enginvr/MESP/MESP_board_real.png

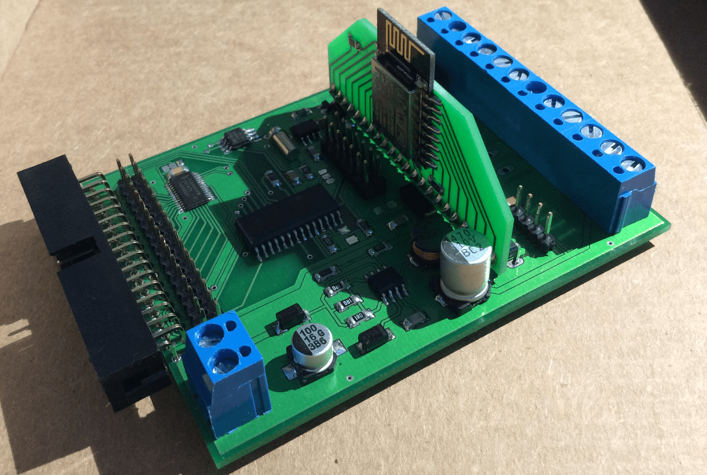
MESP_board_real.png
