enginvr/MESP/README.md

MESP, это аппаратная реализация проекта ESP8266 MegaD api http://ab-log.ru/forum/viewtopic.php?f=1&t=1130.

Основная информация в документе Guide.pdf
