enginvr/MESP/esp MD 3D.png

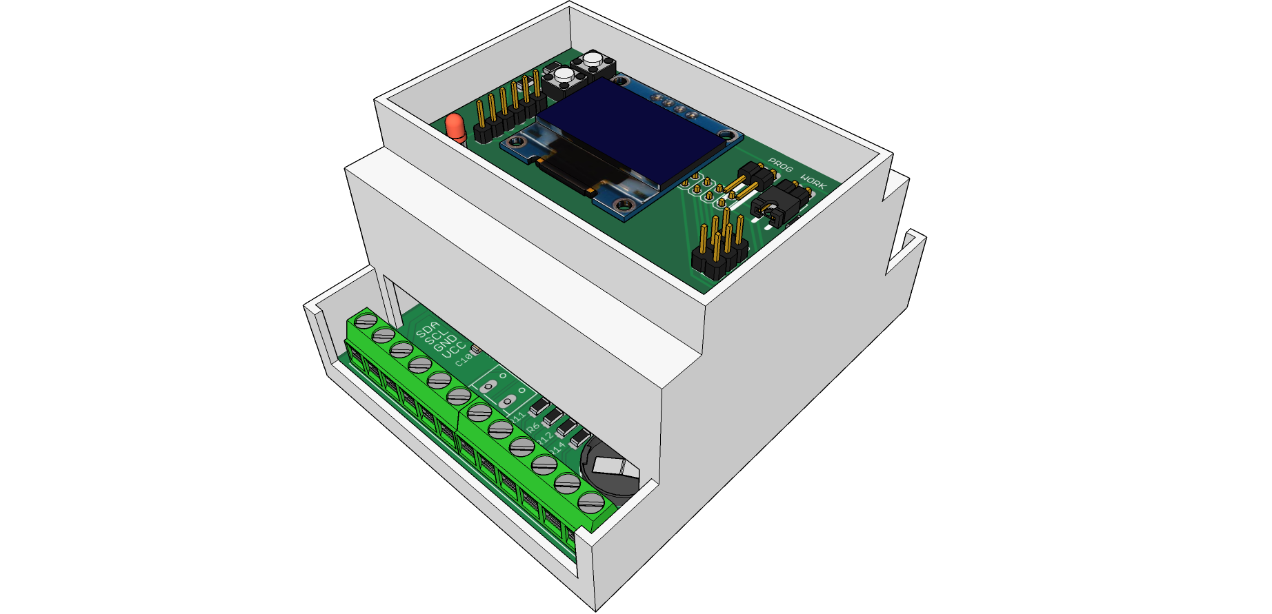
esp MD 3D.png
