enginvr/MESP/scheme_adapter_board.png

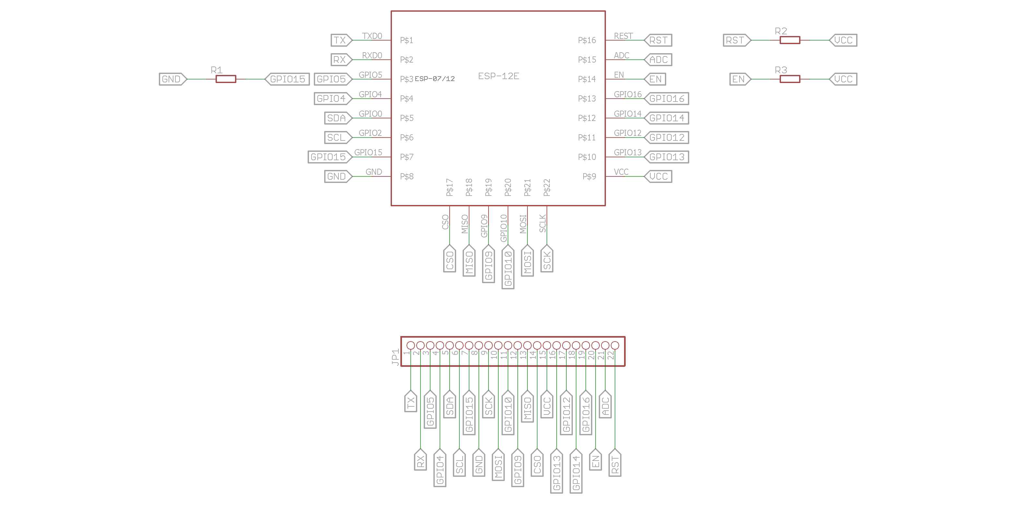
scheme_adapter_board.png
