enginvr/MESP/scheme_main_board.png

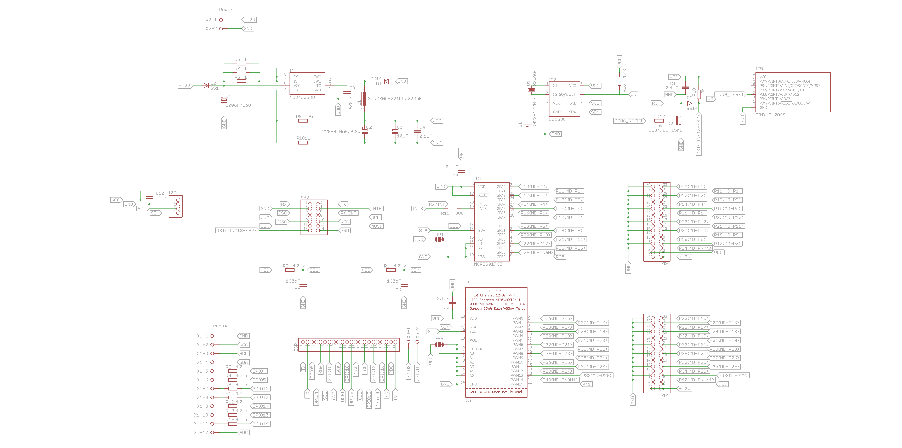
scheme_main_board.png
