enginvr/MESP/scheme_top_board.png

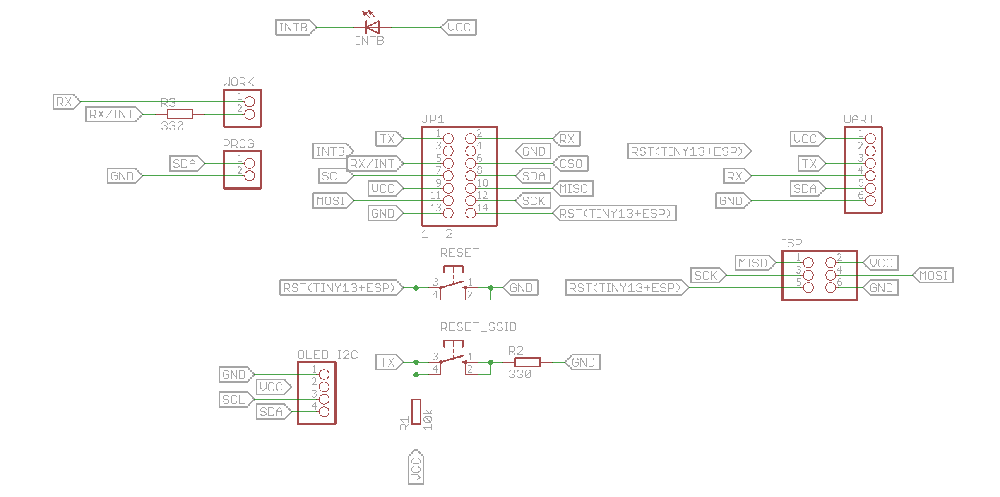
scheme_top_board.png
