enginvr/MESP/EagleCAD schemes/ESP8266 MegaD top board.sch

## EAGLE design EagleCAD schemes/ESP8266 MegaD top board.sch (2016-11-07)

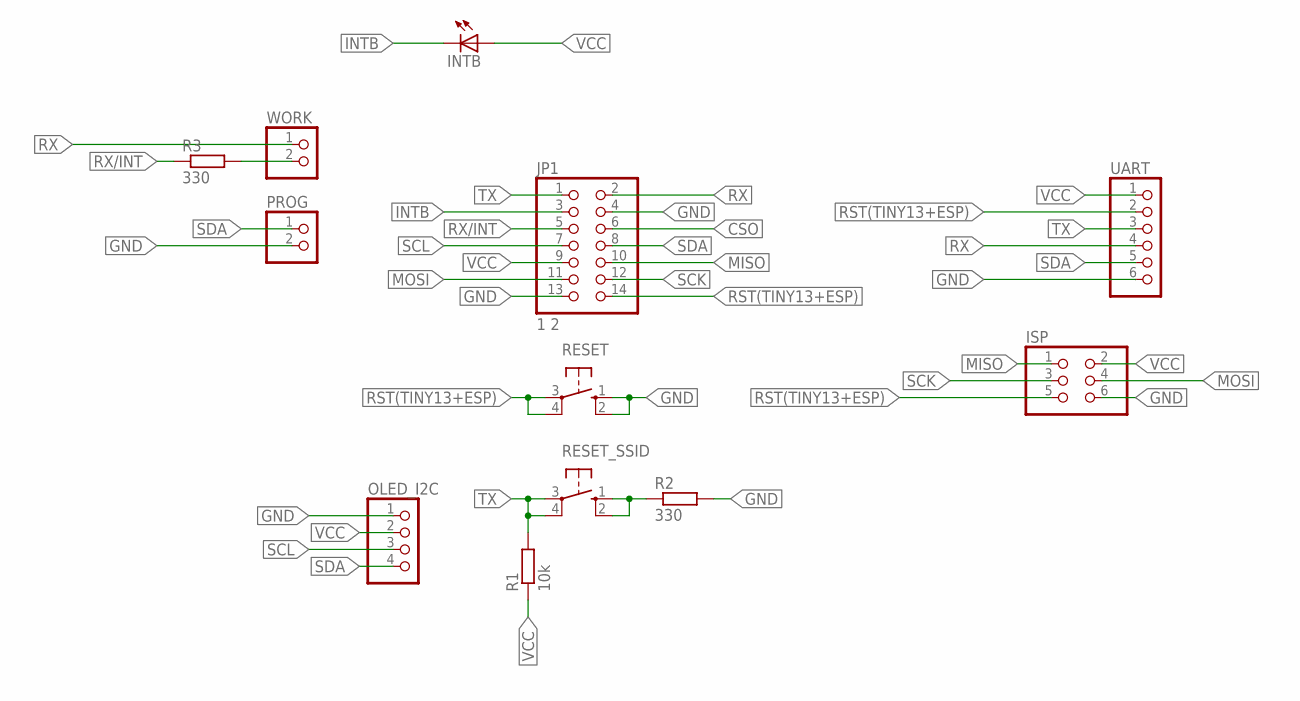
[picture p7: schematic ESP8266 MegaD top board.sch]

Parts:
INTB: LED3MM
ISP: PINHD-2X3; 2X03
JP1: 1 2; 2X07
OLED_I2C: PINHD-1X4; 1X04
PROG: PINHD-1X2/90; 1X02/90
R1: 10k; R1206
R2, R3: 330; R1206
RESET: 10-XX; B3F-10XX
RESET_SSID: 10-XX; B3F-10XX
UART: PINHD-1X6; 1X06
WORK: PINHD-1X2/90; 1X02/90

Connections:
CSO: JP1.6
GND: ISP.6, JP1.4, JP1.13, OLED_I2C.1, PROG.2, R2.2, RESET.1 (S), RESET.2 (S1), UART.6
INTB: INTB.K (C), JP1.3
MISO: ISP.1, JP1.10
MOSI: ISP.4, JP1.11
unnamed: R2.1, RESET_SSID.1 (S), RESET_SSID.2 (S1)
unnamed: R3.2, WORK.2
RST(TINY13+ESP): ISP.5, JP1.14, RESET.3, RESET.4 (P1), UART.2
RX: JP1.2, UART.4, WORK.1
RX/INT: JP1.5, R3.1
SCK: ISP.3, JP1.12
SCL: JP1.7, OLED_I2C.3
SDA: JP1.8, OLED_I2C.4, PROG.1, UART.5
TX: JP1.1, R1.2, RESET_SSID.3, RESET_SSID.4 (P1), UART.3
VCC: INTB.A, ISP.2, JP1.9, OLED_I2C.2, R1.1, UART.1
