enginvr/MESP/(commit log)

2016-09-17 Gerber files
    Add gerber files for PCB
    [brd.gbr]
2016-11-07 Addition
    +eaglecad schemes
    +MESP photo
    [ESP8266 MegaD adapter board v0.1.sch, ESP8266 MegaD top board.sch, ESP8266 MegaD v0.9.sch]
